anayksha/scioly-ev/trajectory.cpp

#include "trajectory.h"

Trajectory::Trajectory(long targetD, double targetT) {
  this->targetD = targetD;
  this->targetT = targetT; 

  t_a = (accel * targetT - sqrt(pow(accel * targetT, 2) - (4 * accel * targetD))) / (2*accel);
  t_c = targetT - (2*t_a);
  v_c = accel * t_a;
  
  phase1Dist = 0.5 * accel * pow(t_a, 2);
  phase2Dist = v_c * t_c + phase1Dist;
}

double Trajectory::getTargetVel(double t) {
  if(t < t_a) {
    return accel * t;
  }
  if(t < t_a + t_c) {
    return v_c;
  }
  if(t < 2*t_a + t_c) {
    return -accel * (t - t_a - t_c) + v_c;
  }
  return 50; // needed bc ts usually doesnt go past the finish
}

long Trajectory::getTargetPos(double t) {
  if(t < t_a) {
    return 0.5 * accel * pow(t, 2);
  }
  if(t < t_a + t_c) {
    return v_c * (t - t_a) + phase1Dist;
  }
  if(t < 2*t_a + t_c) {
    return -0.5 * accel * pow(t - t_a - t_c, 2) + v_c * (t - t_a - t_c) + phase2Dist;
  }
  return targetD; 
}
