anayksha/scioly-ev/(commit log)

2025-12-16 fixed encoder logic
2025-12-16 fixed oopsie date in readme 🙃
2025-12-17 kinda started pid code
2025-12-17 created trajectory class for PID target calculations
2025-12-18 skeleton for PID
2025-12-19 i think i implemented PID
2025-12-20 basic code for control rotary encoder
    theres a new controls class that will be used to track changes in the rotary encoder and update targetD and targetT accordingly for easy setting onsite
2025-12-20 added display functionality
    atp i think ts is basically done and we j have to do random things like make sure pin numbers are good, find out the PID constants, and acc find out the address for the display
2025-12-21 added schematic and idk what else
2025-12-22 bugfix with pwm sign in driveMotor()
    if the given pwm value was negative driveMotor() would call .turnLeft() instead of .turnRight() but the negative pwm value would be passed in instead of its absolute value
    [ev_pain.ino]
2025-12-24 bugfix with accessing accel in trajectory
    since accel is a const variable it needs to be declared as extern in ev_pain.ino as well. Also added some code that display when the vehicle is ready to run and the acc dist and time traveled on the SSD1306 display
    [ev_pain.ino]
2025-12-28 changed pin nums for esp32
    also updated readme and vel PID interval to match esp32 change
2025-12-28 switched from Encoder library to ESP32Encoder
2025-12-30 figured out i2c address
2026-01-02 bigfix with PID timing control and added motor deadzone compensation
    initially, to the lastPID calculation times, I assigned them to -2 times the PID interval, so that it could technically work if the start button was pressed right after startup. However, the PID interval were unsigned values, so -2 got converted to a really big unsigned value, and so since the lastPID times were really big numbers past the current runTime, the difference between them was negative and that one if statement that controls the timing would never have evaluated to true
2026-01-02 fixed possible error with unsigned CPR val
    [ev_pain.ino]
2026-01-02 bugfix with 1st run of vel PID loop
    since i set the initial lastPID values to negative numbers, when calculating dt for velocity measurement, dt would be too high and would underestimate velocity
    [ev_pain.ino]
2026-01-02 modified controls class to use ESP32Encoder
2026-01-05 updated wiring diagram and improved documentation
2026-01-06 minor schematic update
    the ESP32 pins connected to the motor encoder pins were not accurate to what was in the code
2026-01-07 removed unnecessary delay after displaying fin dist & time
    the screen only updates whenever it detects a change in the rotary encoder used for setting target dist and time so the final measured dist and time will persist until the controls are updated
2026-01-08 changed some things to update motor direction and deadzone
2026-01-08 bigfix with dt (time) in measured velocity calcualtions
2026-01-08 whyd i run the pos PID in the vel loop
2026-01-08 fixed bug by overriding PID library internal interval
    [scioly_ev.ino]
2026-01-08 updated PID time intervals to be better
2026-01-12 bugfix with ctrl enc button not being set up
    [controls.cpp]
2026-01-15 added vel filtering
2026-01-15 bugfix with ctrl enc responsiveness
    ts encoder value used to reset to 0 whenever detected a change, so if not moved fast enough, ts would reset to 0 without reaching a magnitude of 4 and acc updating the target variables
    [controls.cpp]
2026-01-16 transfered PID constants and other tested values
2026-01-31 bugfix with initial value of phase1Dist in trajectory.cpp
    [scioly_ev.ino, trajectory.cpp]
2026-01-31 MAJOR bugfix with trajectory timing and bugfix with pos loop in cascade PID
    so basically the Trajectory class used to expect a long for time instead of a double so any inputted values would be truncated. Now that is fixed. Also the line that added the pos PID output to the vel PID setpoint was commented so i uncommented that
    [controls.cpp, scioly_ev.ino, trajectory.cpp, trajectory.h]
